beetlebugorg/mini/docs/lineart/img/corner-dark.png

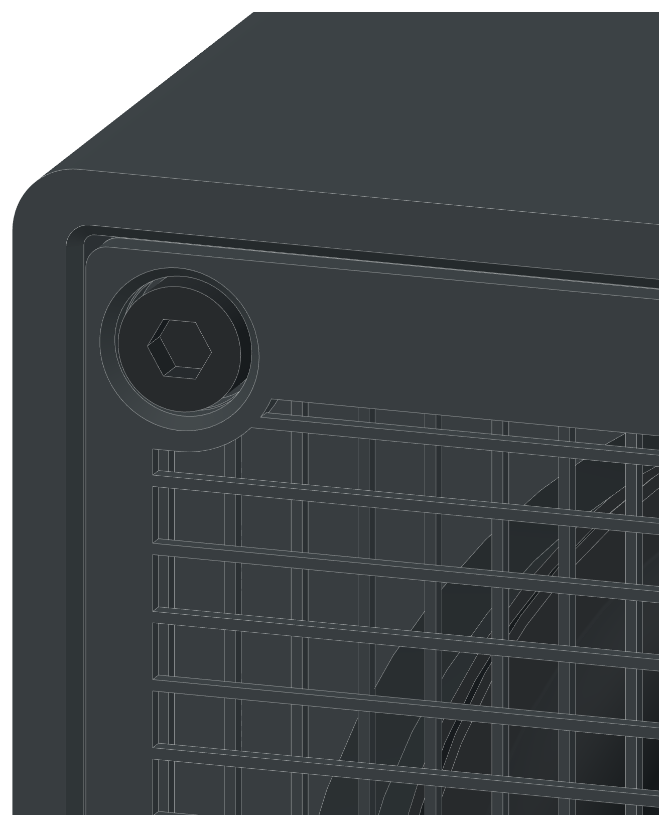
docs/lineart/img/corner-dark.png
