beetlebugorg/mini/docs/lineart/img/corner-light.png

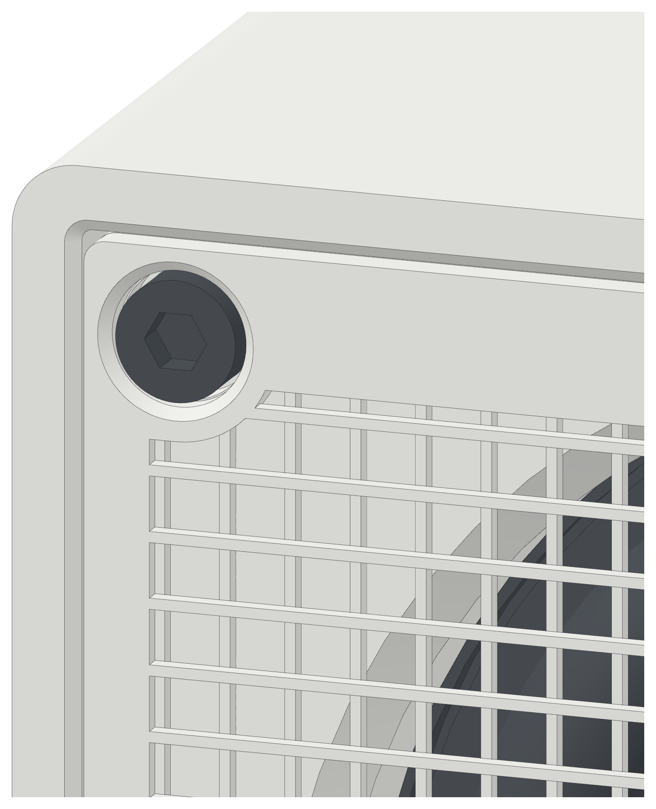
docs/lineart/img/corner-light.png
