beetlebugorg/mini/docs/lineart/img/exploded-dark.png

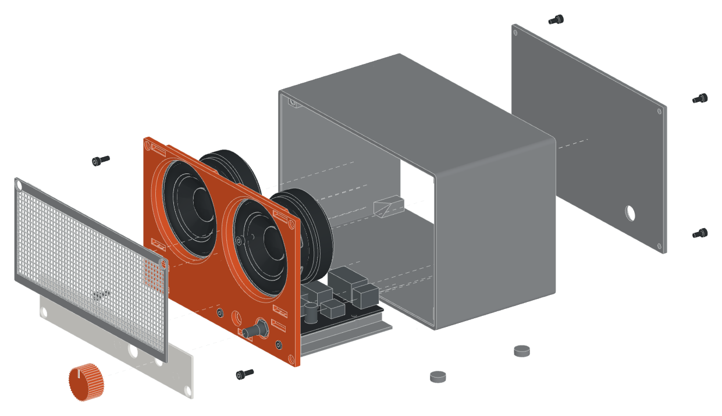
docs/lineart/img/exploded-dark.png
