beetlebugorg/mini/docs/lineart/img/front-light.png

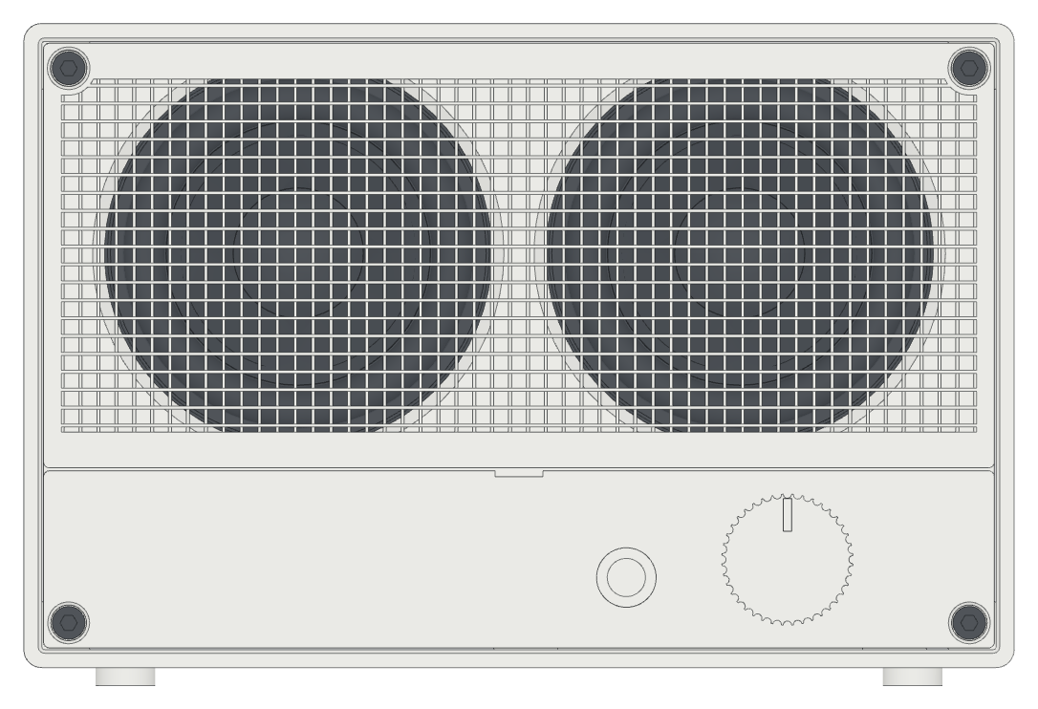
docs/lineart/img/front-light.png
