beetlebugorg/mini/docs/lineart/img/hero-dark.png

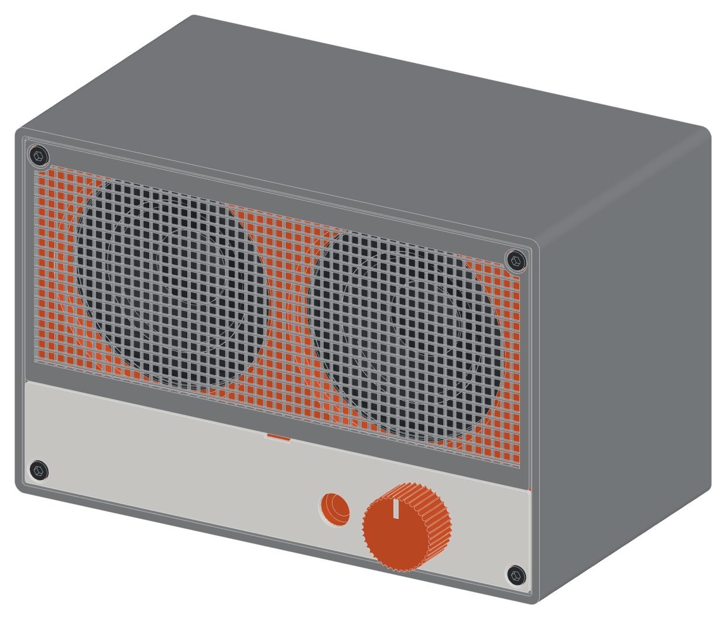
docs/lineart/img/hero-dark.png
