beetlebugorg/mini/docs/lineart/img/pocket-dark.png

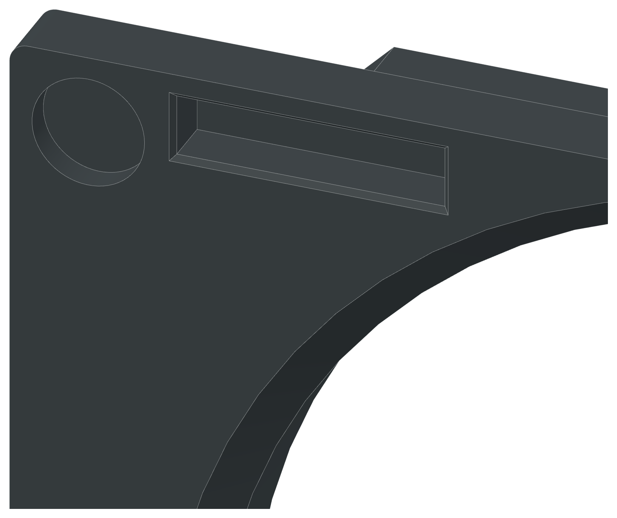
docs/lineart/img/pocket-dark.png
