beetlebugorg/mini/docs/lineart/img/rear-dark.png

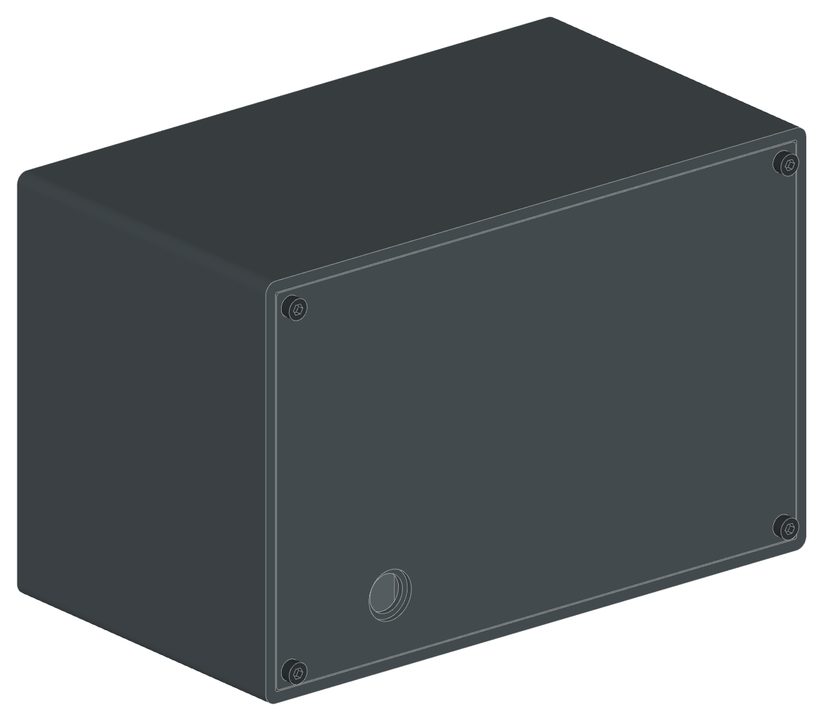
docs/lineart/img/rear-dark.png
