beetlebugorg/mini/docs/lineart/img/snap-light.png

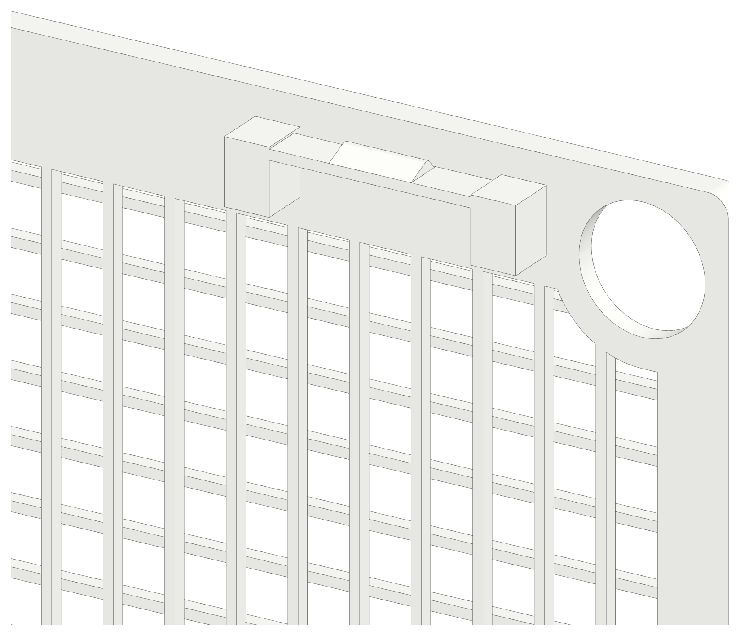
docs/lineart/img/snap-light.png
