beetlebugorg/mini/docs/report-mini/img/baffle_front.png

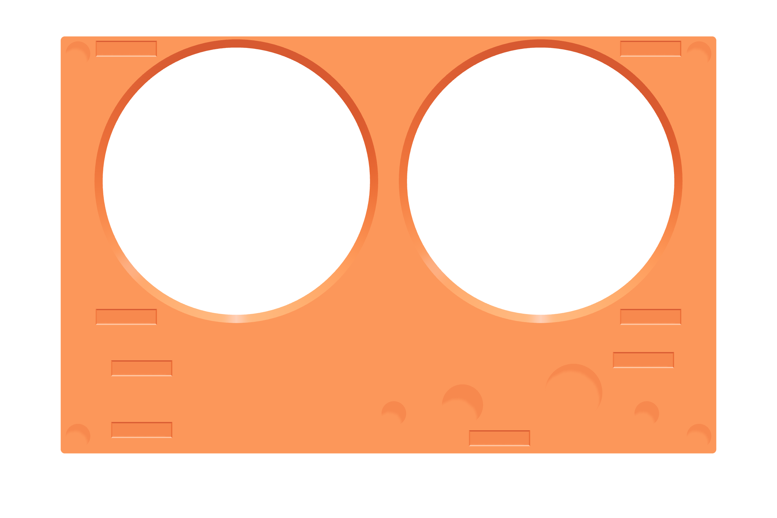
docs/report-mini/img/baffle_front.png
