beetlebugorg/mini/docs/report-mini/img/cut_corner.png

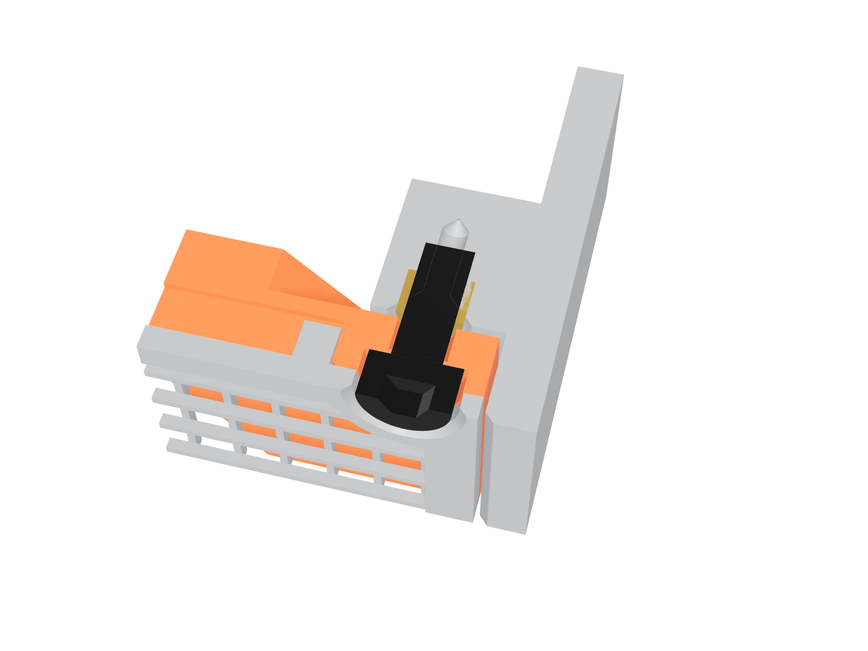
docs/report-mini/img/cut_corner.png
