beetlebugorg/mini/docs/report-mini/img/cut_rear.png

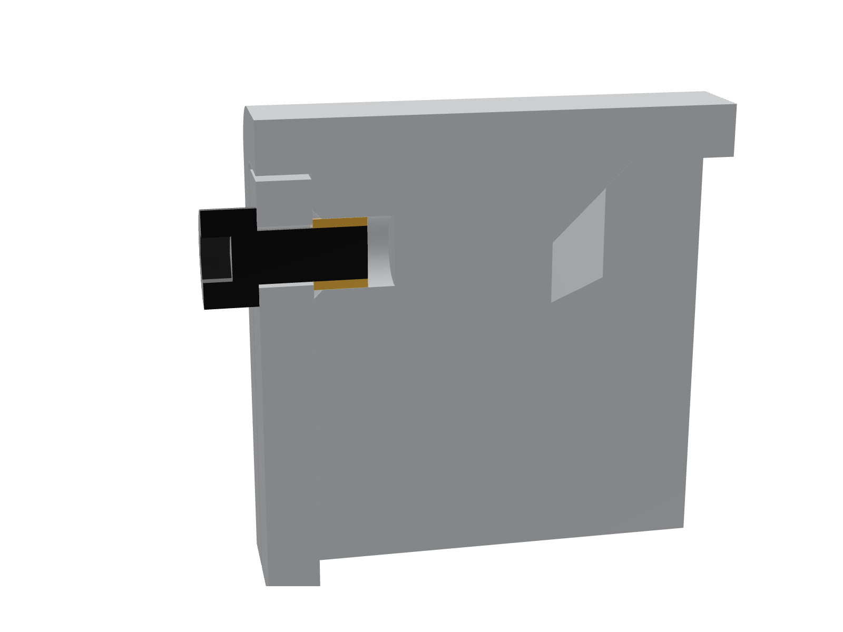
docs/report-mini/img/cut_rear.png
