beetlebugorg/mini/docs/report-mini/img/cut_tray.png

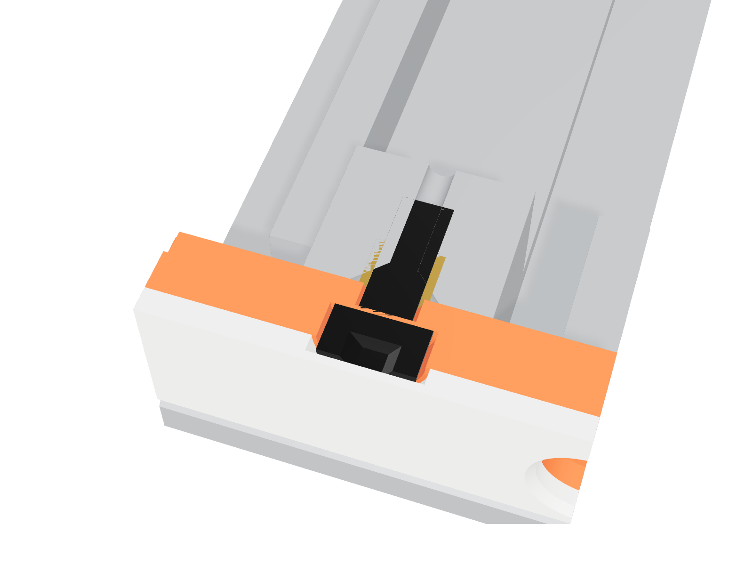
docs/report-mini/img/cut_tray.png
