beetlebugorg/mini/docs/report-mini/img/front.png

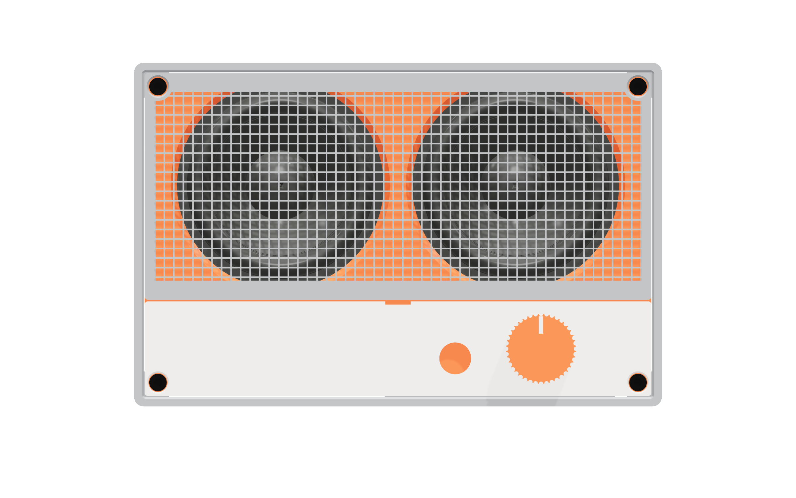
docs/report-mini/img/front.png
