beetlebugorg/mini/docs/report-mini/img/grille_back.png

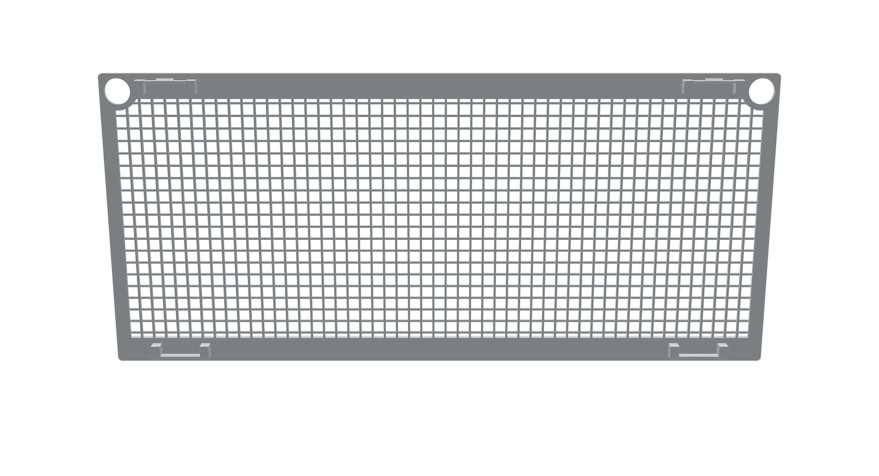
docs/report-mini/img/grille_back.png
