beetlebugorg/mini/docs/report-mini/img/hero.png

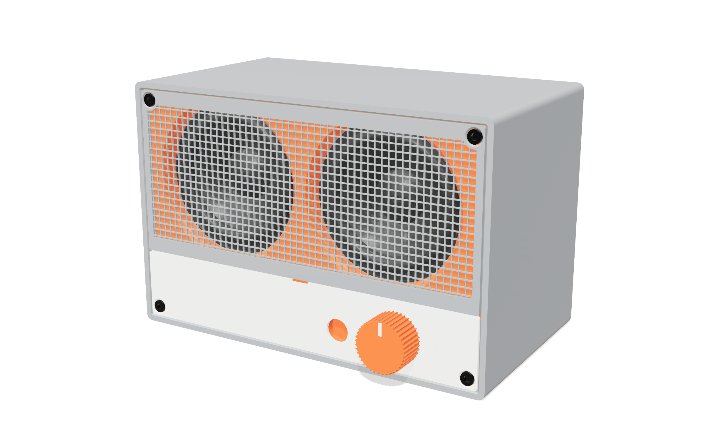
docs/report-mini/img/hero.png
