beetlebugorg/mini/docs/report-mini/img/rear.png

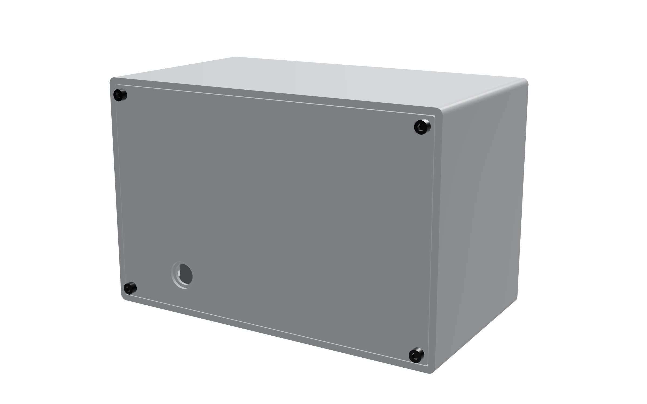
docs/report-mini/img/rear.png
