beetlebugorg/mini/docs/report-mini/img/rear_panel.png

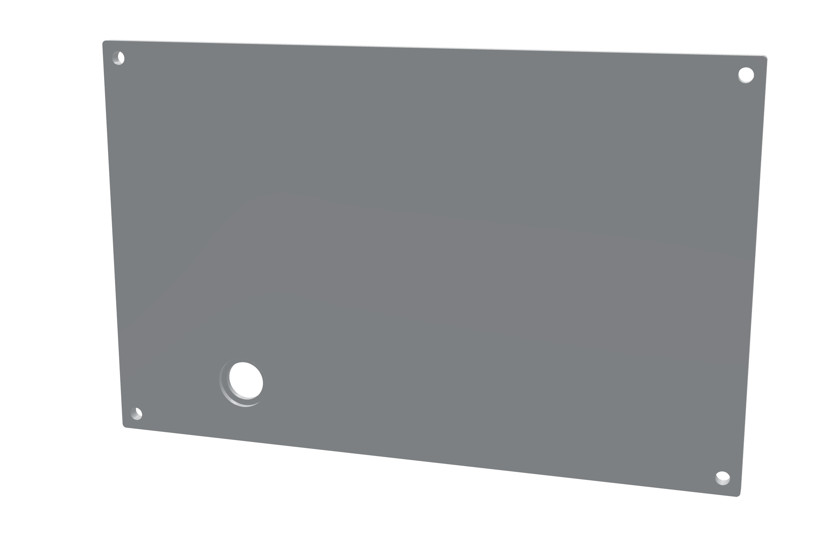
docs/report-mini/img/rear_panel.png
