beetlebugorg/mini/docs/report-mini/img/side.jpg

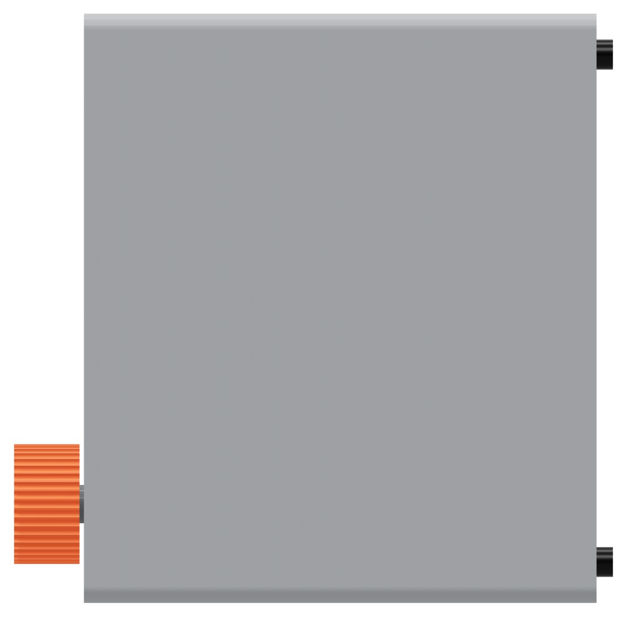
docs/report-mini/img/side.jpg
