beetlebugorg/mini/docs/report-mini/img/top.png

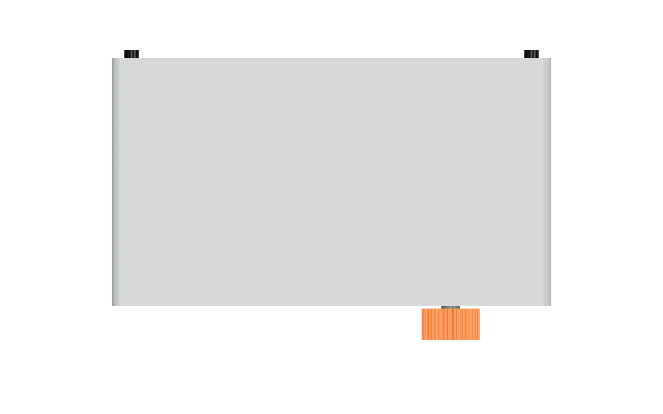
docs/report-mini/img/top.png
