beetlebugorg/mini/docs/report-mini/img/tray.png

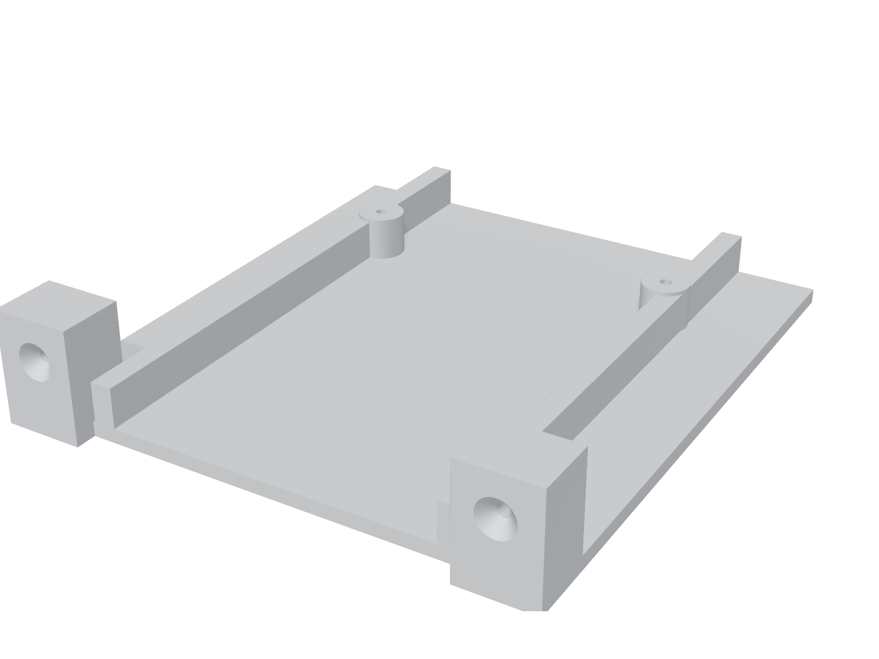
docs/report-mini/img/tray.png
