beetlebugorg/mini/docs/specs-mini/snap.jpg

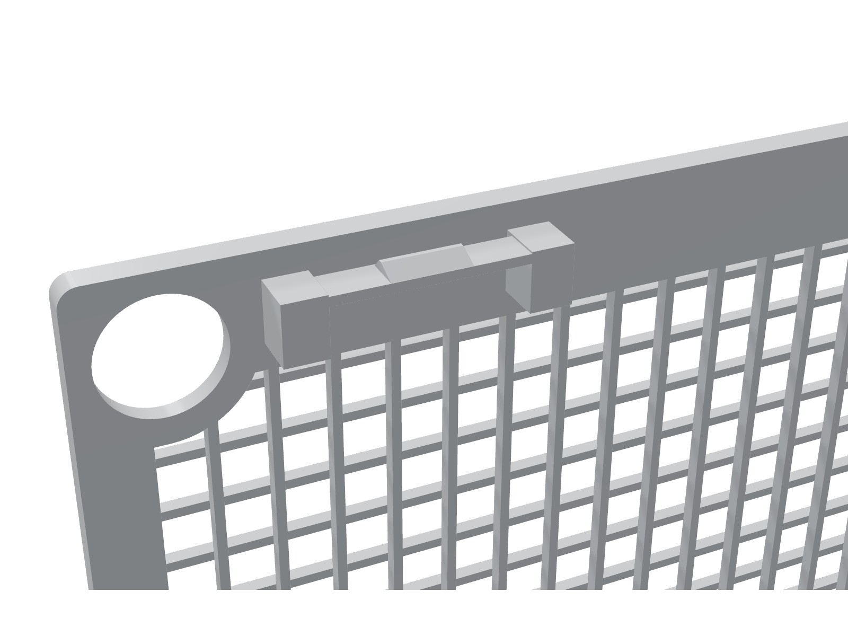
docs/specs-mini/snap.jpg
