beetlebugorg/mini/cad/assembly-mini/amp_board.stl

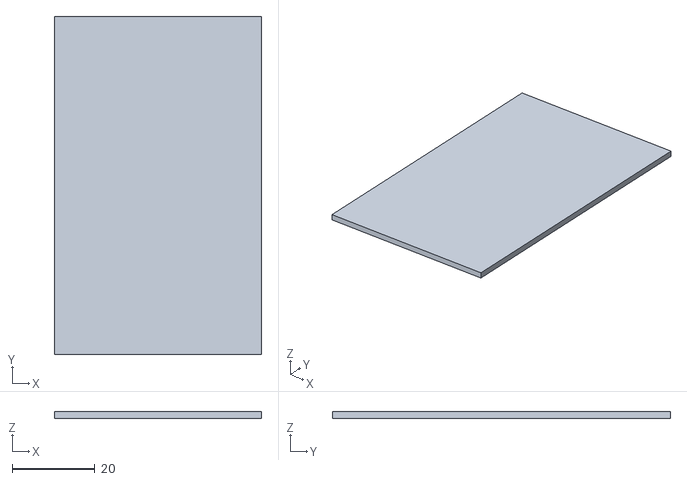
[picture p37: CAD file, 2026-11-04]
cad/assembly-mini/amp_board.stl
50.1 x 81.8 x 1.60
