beetlebugorg/mini/cad/step-mini/sleeve.step

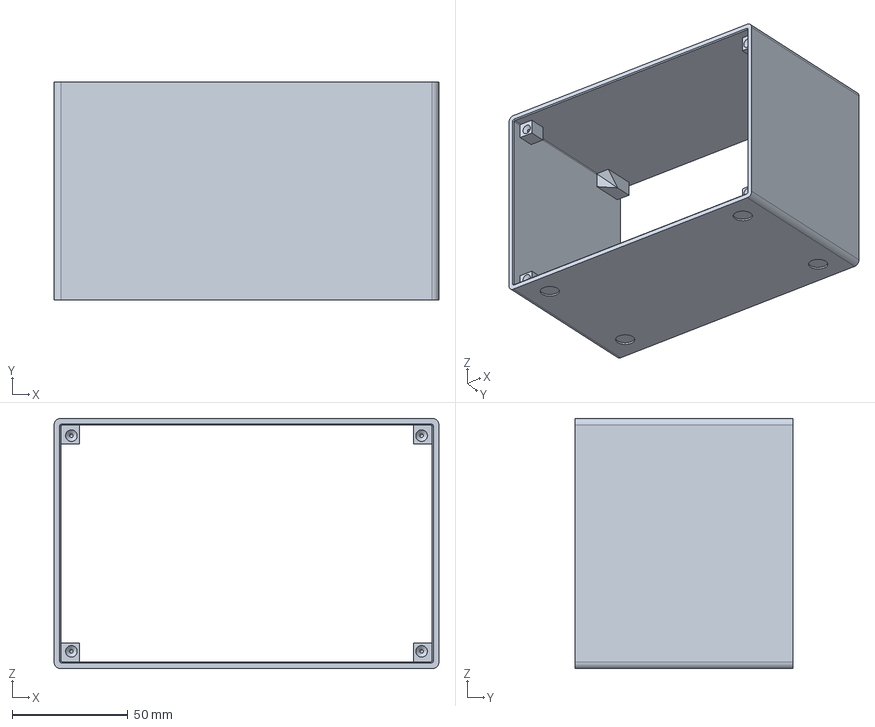
[picture p38: CAD file, 2026-10-19]
cad/step-mini/sleeve.step
166.0 x 94.0 x 108.0 mm
