beetlebugorg/mini/cad/stl-mini/tray.stl

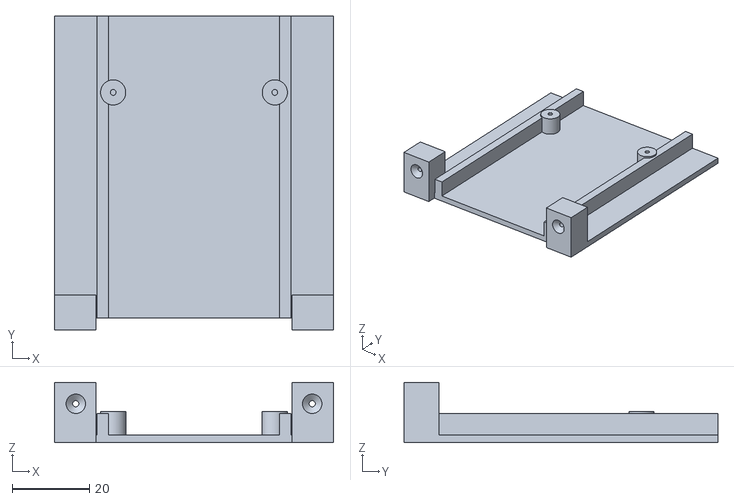
[picture p39: CAD file, 2026-11-04]
cad/stl-mini/tray.stl
72.1 x 81.0 x 15.5
