beetlebugorg/mini/cad/stl-mini/knob.stl

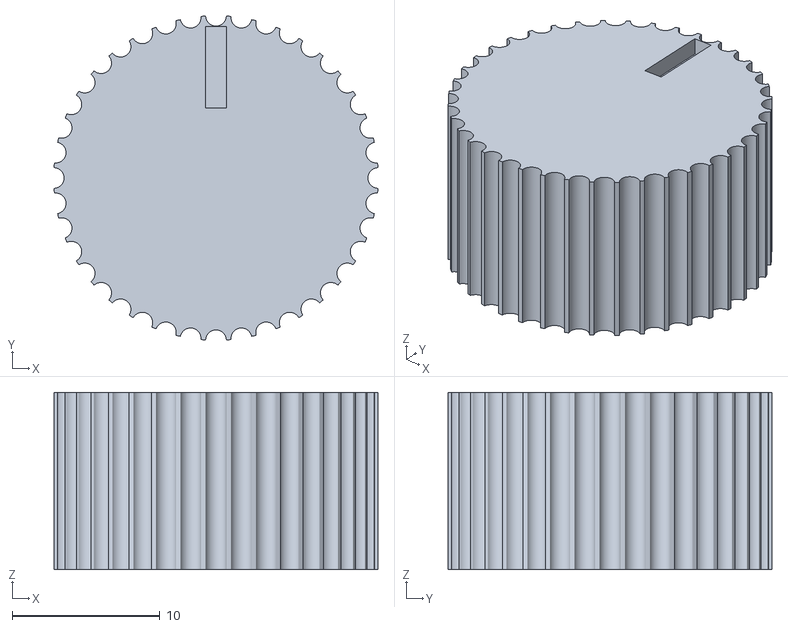
[picture p40: CAD file, 2026-10-19]
cad/stl-mini/knob.stl
22.0 x 22.0 x 12.0
