beetlebugorg/mini/cad/step-mini/rear_panel.step

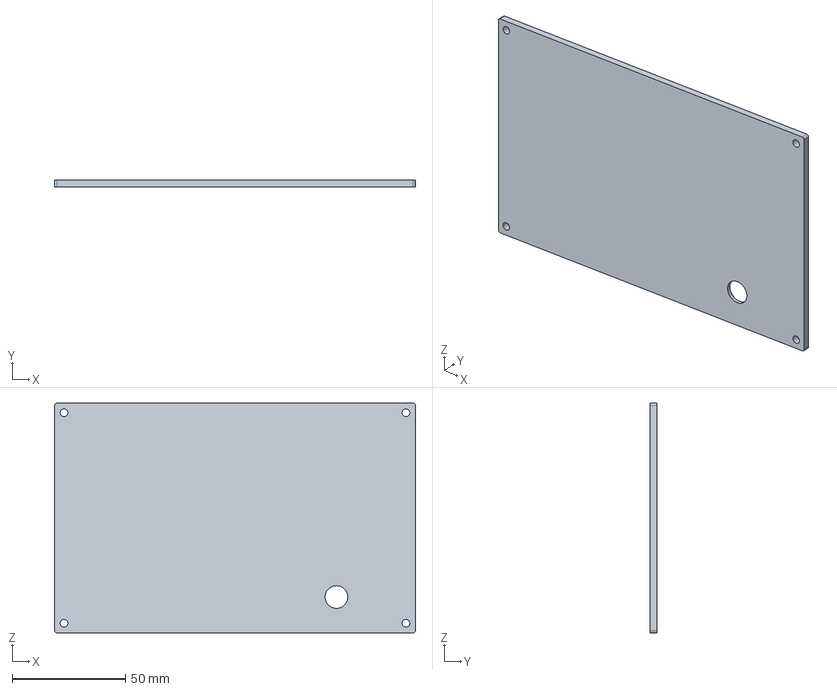
[picture p41: CAD file, 2026-10-19]
cad/step-mini/rear_panel.step
159.4 x 3.00 x 101.4 mm
