beetlebugorg/mini/cad/stl-mini/grille_holes.stl

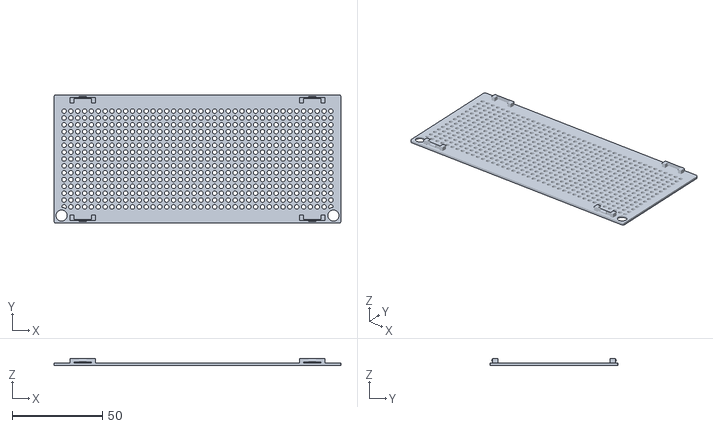
[picture p42: CAD file, 2026-10-19]
cad/stl-mini/grille_holes.stl
159.4 x 71.2 x 4.00
