beetlebugorg/mini/cad/stl-mini/grille_infill_presets.3mf

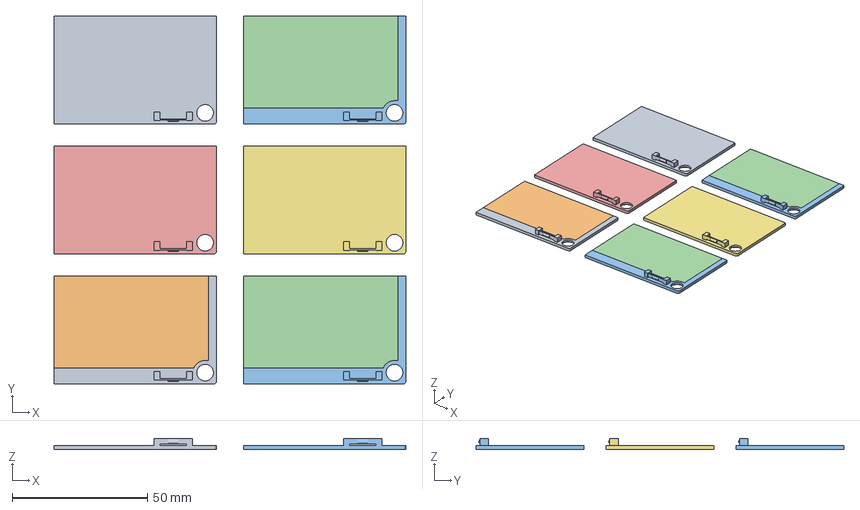
[picture p43: CAD file, 2026-10-19]
cad/stl-mini/grille_infill_presets.3mf
130.0 x 136.0 x 4.00 mm
coupon 1 plate
coupon 1 window (Lattice 3.0)
coupon 2 plate
coupon 2 window (Lattice 2.0)
coupon 3 plate
coupon 3 window (Diamond 3.0)
coupon 4 plate
coupon 4 window (Grid 3.0)
coupon 5 plate
coupon 5 window (Triangles 4.0)
coupon 6 plate
coupon 6 window (Trihexagon 4.0)
