beetlebugorg/mini/cad/assembly-mini/speaker_r.stl

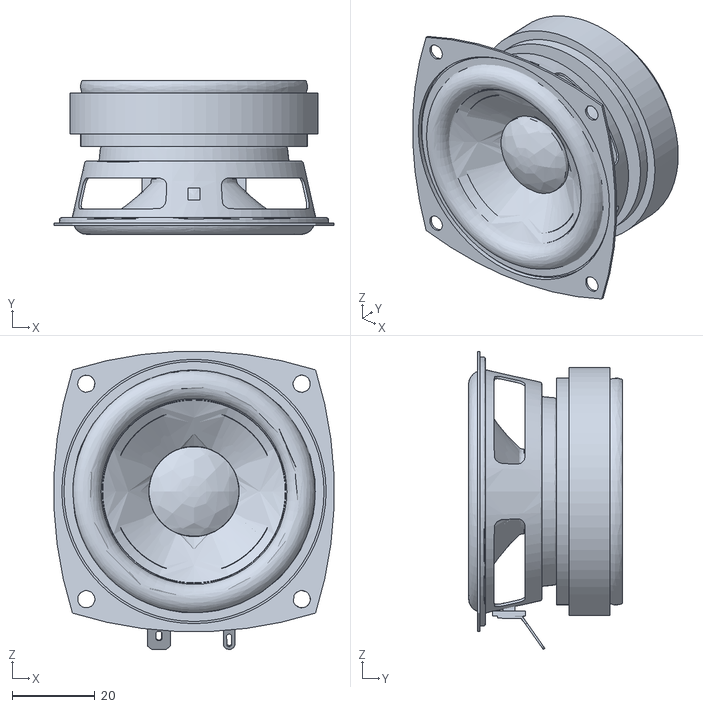
[picture p44: CAD file, 2026-11-03]
cad/assembly-mini/speaker_r.stl
67.8 x 37.3 x 72.2
