beetlebugorg/mini/cad/step-mini/knob_mark.step

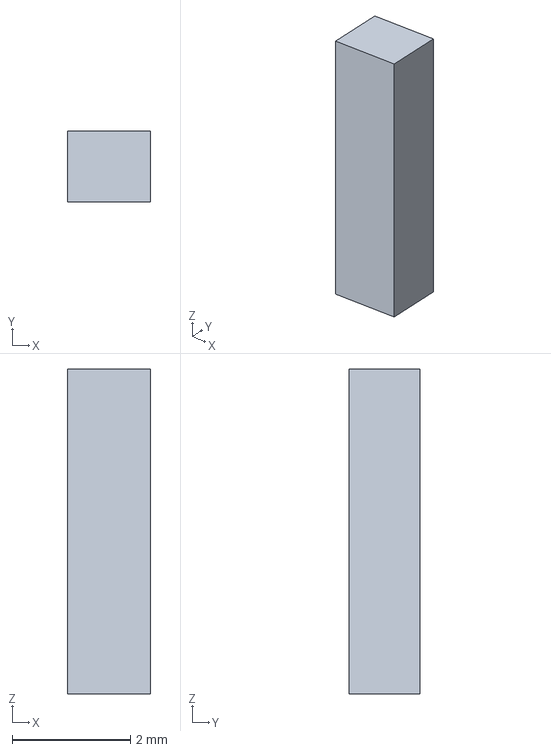
[picture p45: CAD file, 2026-10-19]
cad/step-mini/knob_mark.step
1.40 x 1.20 x 5.50 mm
