beetlebugorg/mini/cad/step-mini/baffle.step

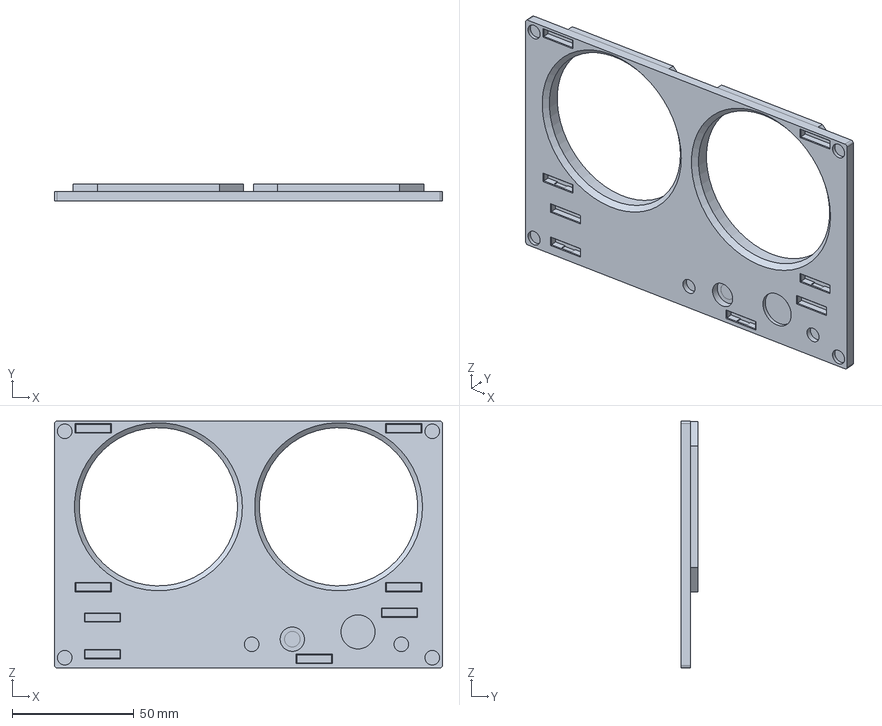
[picture p46: CAD file, 2026-10-19]
cad/step-mini/baffle.step
159.4 x 7.00 x 101.4 mm
