beetlebugorg/mini/cad/assembly-mini/inserts_tray.stl

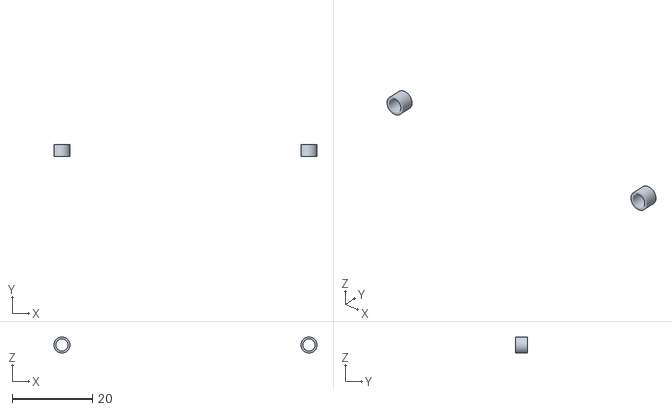
[picture p47: CAD file, 2026-11-03]
cad/assembly-mini/inserts_tray.stl
65.5 x 3.00 x 3.98
