beetlebugorg/mini/cad/step-mini/feet.step

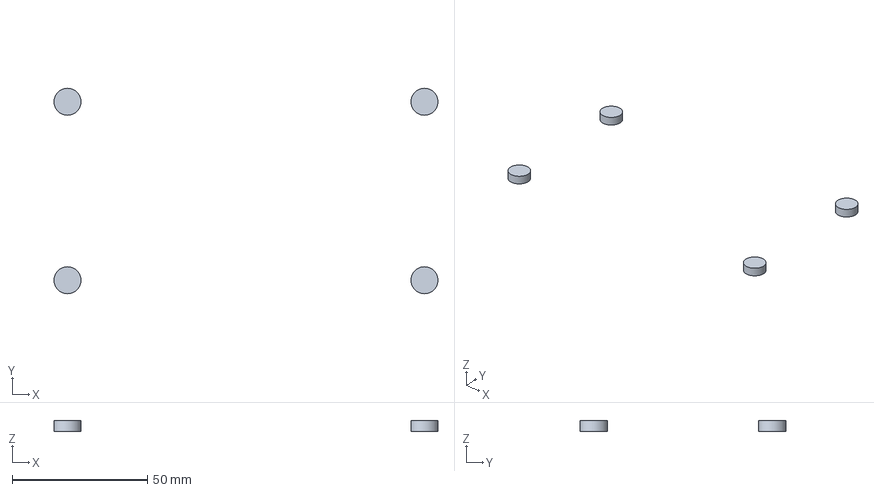
[picture p48: CAD file, 2026-10-19]
cad/step-mini/feet.step
142.0 x 76.0 x 3.90 mm
