beetlebugorg/mini/cad/assembly-mini/grille.stl

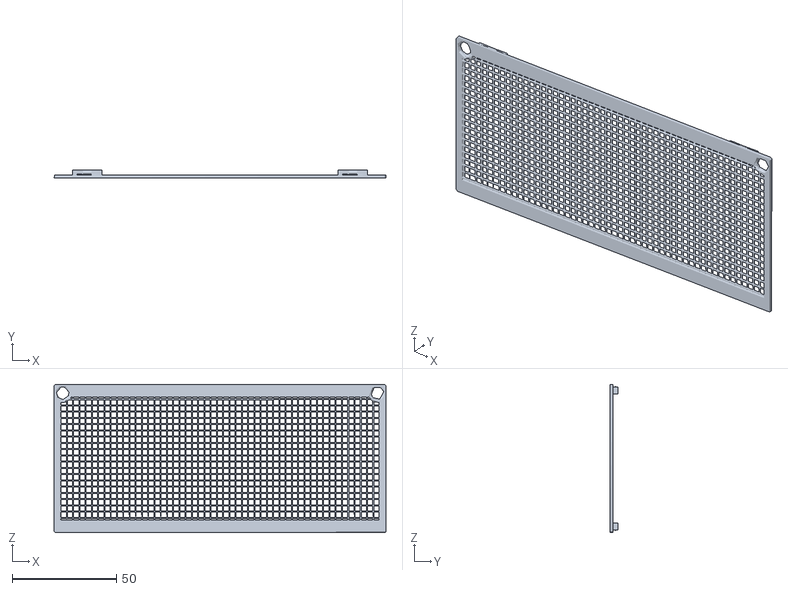
[picture p49: CAD file, 2026-11-03]
cad/assembly-mini/grille.stl
159.3 x 4.00 x 71.2
