beetlebugorg/mini/cad/assembly-mini/control_strip.stl

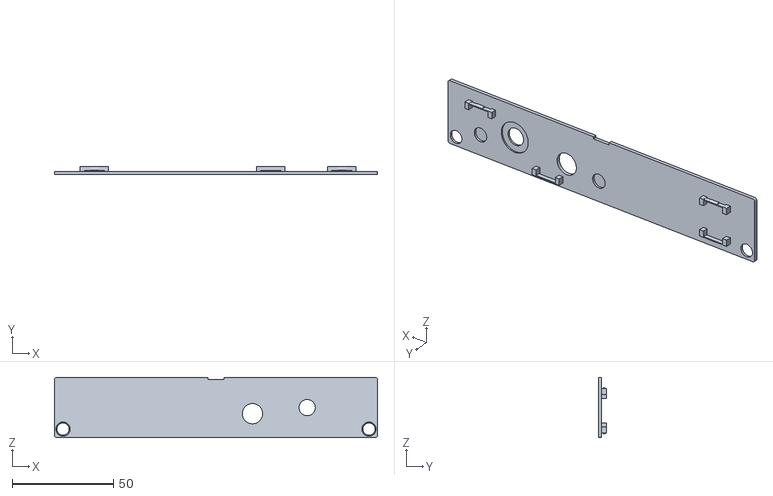
[picture p50: CAD file, 2026-11-03]
cad/assembly-mini/control_strip.stl
159.4 x 4.00 x 29.7
