beetlebugorg/mini/(list of files, cad)

Other CAD files:
cad/assembly-mini/tray.stl
cad/step-mini/grille.step
cad/assembly-mini/sleeve.stl
cad/assembly-mini/knob_mark.stl
cad/assembly-mini/pot_nut.stl
cad/assembly-mini/screws_board.stl
cad/assembly-mini/screws_front.stl
cad/assembly-mini/screws_rear.stl
cad/assembly-mini/screws_tray.stl
cad/step-mini/screws_board.step
cad/step-mini/screws_front.step
cad/stl-mini/feet.stl
cad/stl-mini/grille.stl
