beetlebugorg/mini/docs/lineart/img/step1-light.png

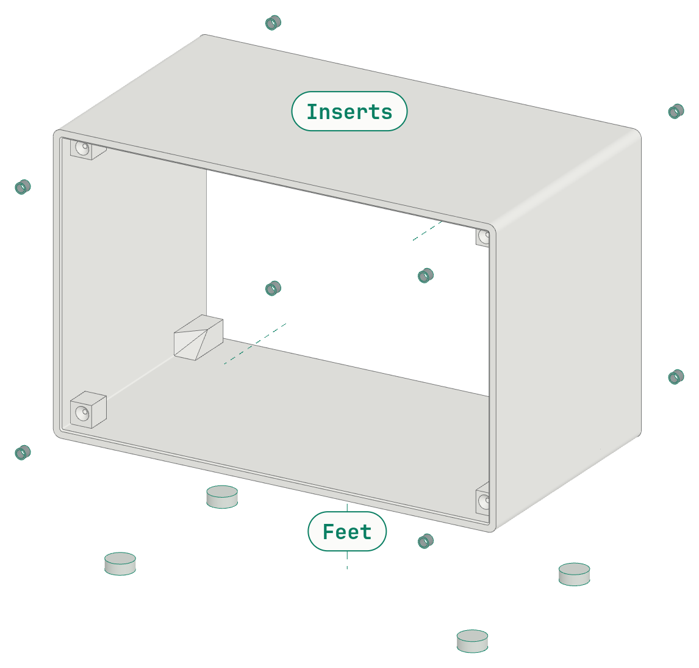
docs/lineart/img/step1-light.png
