beetlebugorg/mini/docs/lineart/img/step2-light.png

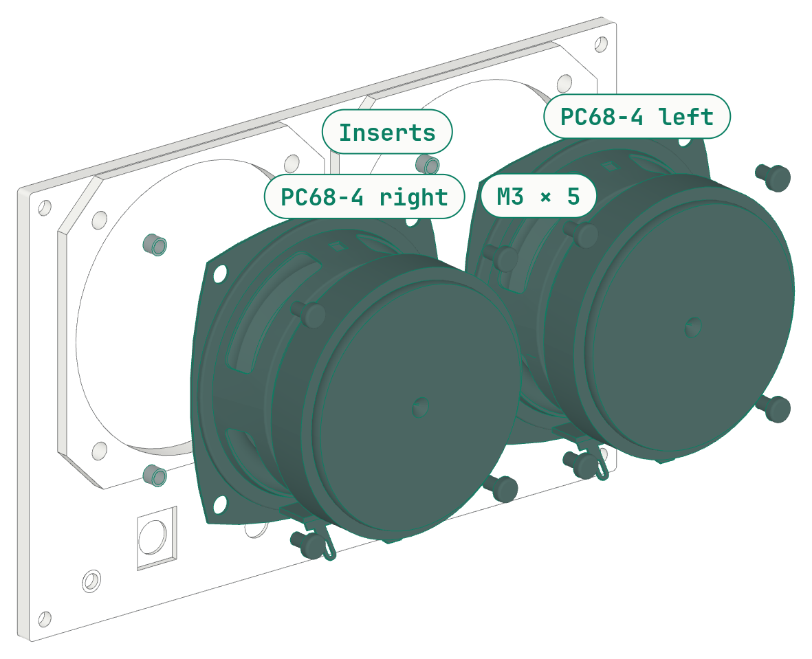
docs/lineart/img/step2-light.png
