beetlebugorg/mini/docs/lineart/img/step4-dark.png

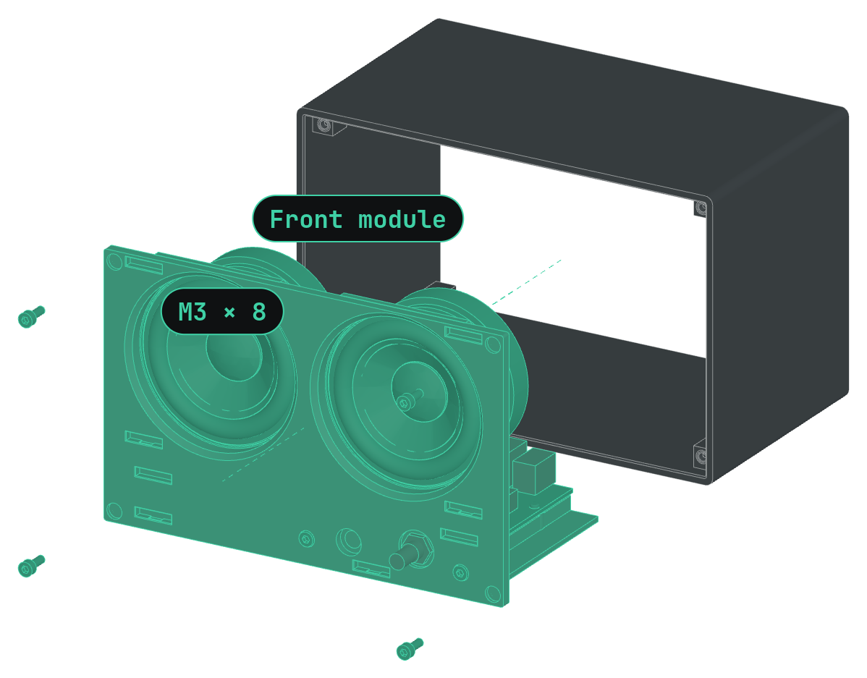
docs/lineart/img/step4-dark.png
