beetlebugorg/mini/docs/lineart/img/step4-light.png

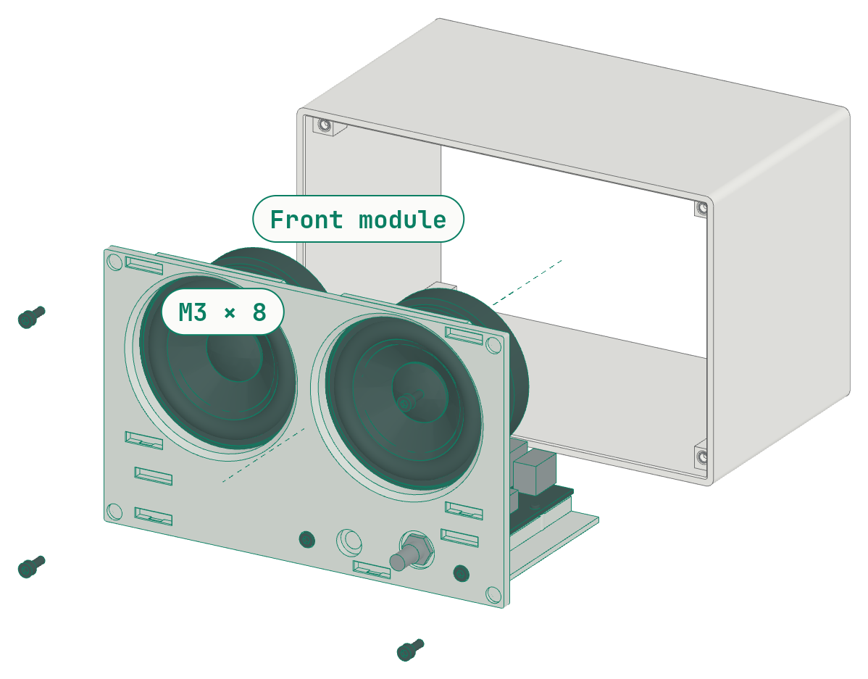
docs/lineart/img/step4-light.png
