beetlebugorg/mini/docs/lineart/img/step5-dark.png

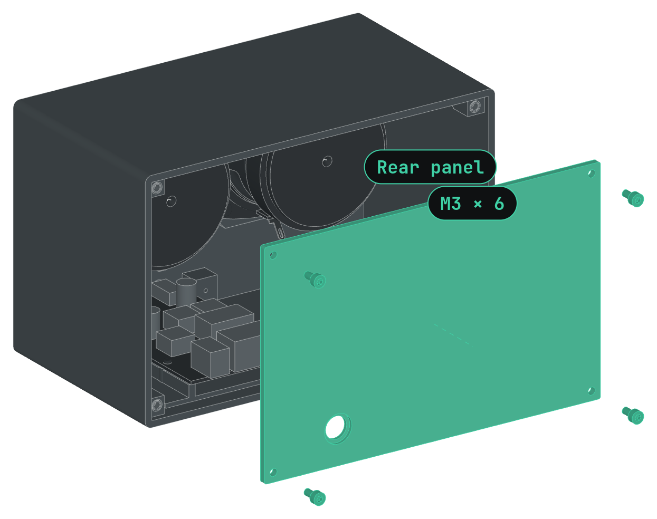
docs/lineart/img/step5-dark.png
