beetlebugorg/mini/docs/report-mini/img/print_baffle.png

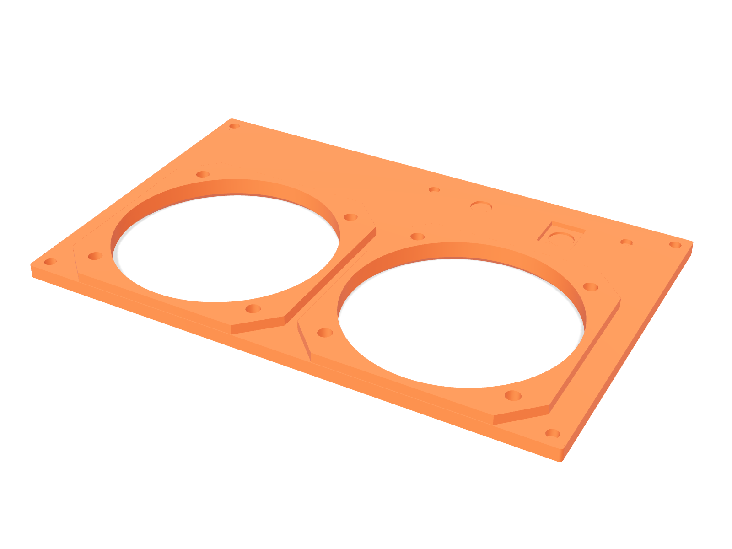
docs/report-mini/img/print_baffle.png
