beetlebugorg/mini/docs/report-mini/img/print_control_strip.png

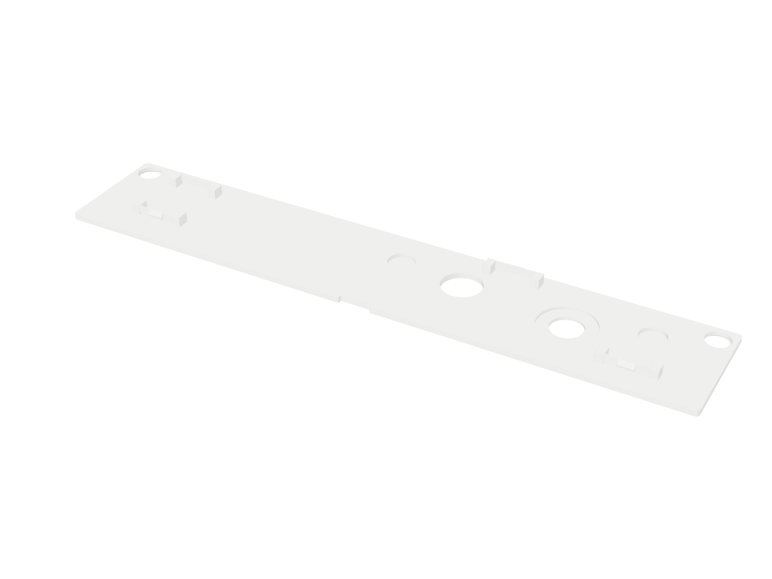
docs/report-mini/img/print_control_strip.png
