beetlebugorg/mini/docs/report-mini/img/print_grille.png

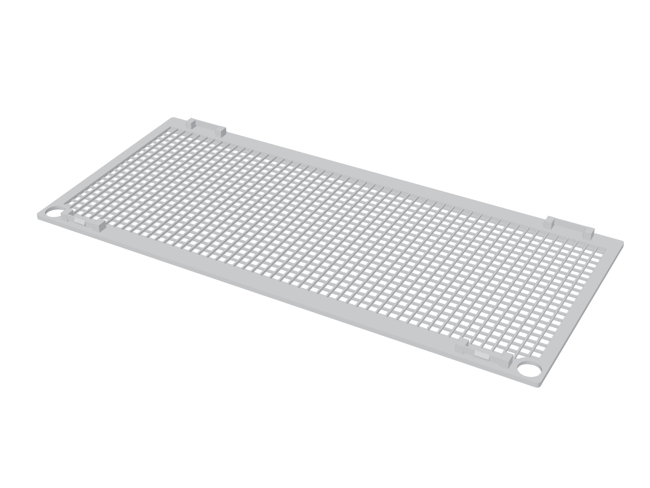
docs/report-mini/img/print_grille.png
