beetlebugorg/mini/docs/report-mini/img/print_sleeve.png

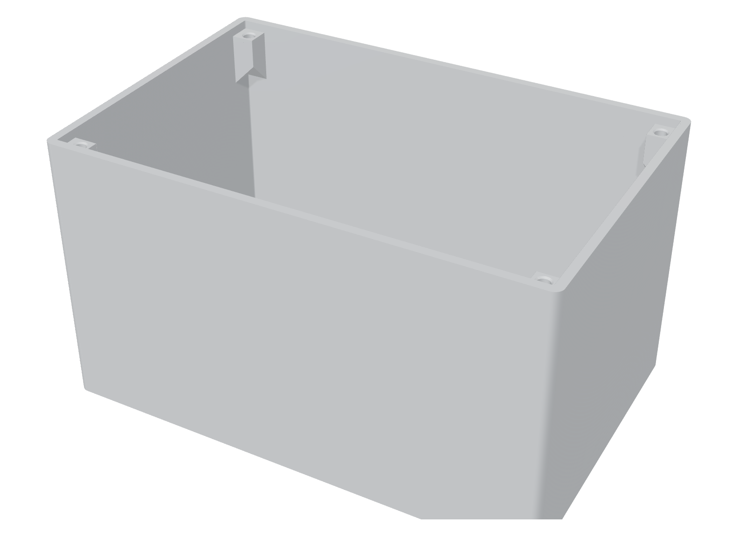
docs/report-mini/img/print_sleeve.png
