beetlebugorg/mini/docs/report-mini/img/print_tray.png

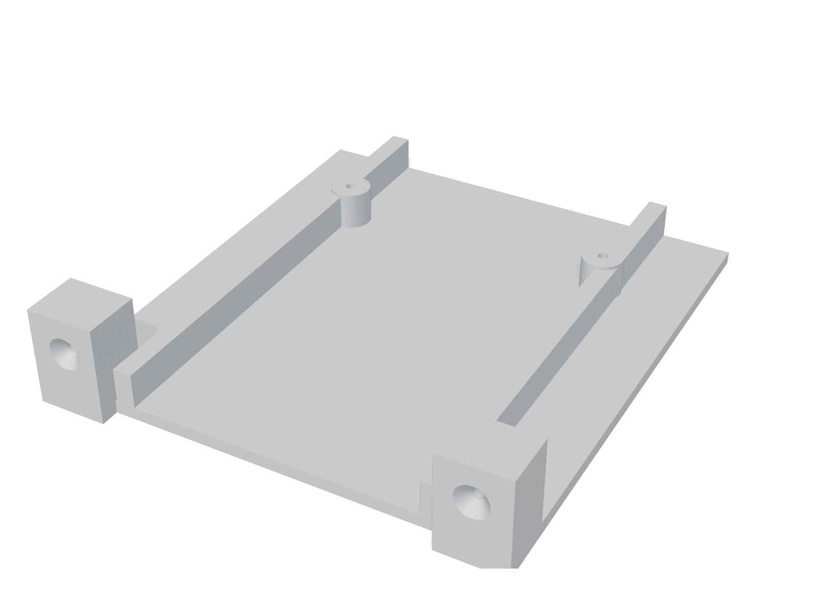
docs/report-mini/img/print_tray.png
