beetlebugorg/mini/(commit log)

2026-10-19 Add the Bluespeaker Mini
    A Bluetooth desk speaker with two PC68-4 drivers and a ZK-502C amplifier.
    The repo has the build123d model, the Cura and Orca profiles, the
    drawings, the spec sheet, the engineering report, and the docs page.
    docs/lineart renders the line-art images in the beetlebug.org style. The
    Pages workflow publishes docs/.
2026-11-03 Render the hero and the exploded view in the filament colors
    The printed parts of these two shots now show their filament: grey,
    orange and white. The drawings stay line art.
2026-11-03 Add printdeck.yml for the Printdeck builds of the Mini
    The plan has the nine printed parts with the Cura profiles of cura/ on
    the TAZ Workhorse SE, three PLA colours, the spec sheet, the report,
    and the Mini in its parts for the Parts tab. cad/mini_assembly.py
    writes the parts in their places from the glTF files of the design
    page.
2026-11-03 Update Pillow, certifi and puppeteer-core for security fixes
    Pillow 13.0.0 and certifi 2026.10.23 fix the open Dependabot alerts
    of uv.lock. threejs-materials 1.2.4 held Pillow below 12.3, and 1.2.5
    allows Pillow 13.
    puppeteer-core 25.16.0 drops extract-zip and basic-ftp from the tree
    of docs/lineart, and gets zod 4.6.7. npm audit reports 0
    vulnerabilities. render.mjs makes the same hero image as before.
2026-11-03 Check the part STL files in the generate step of printdeck.yml
    The plan run on GitHub runs cad/bluespeaker_mini.py --stl and fails
    when the nine part STL files differ from the committed files. A local
    run with the locked packages makes the same files.
2026-11-04 Print the Printdeck grille in white with a honeycomb window
    The export writes cad/stl-mini/grille_honeycomb.3mf: the grille plate
    and a window of honeycomb infill at 20 %, with no walls and no top or
    bottom layers. The Grille part of printdeck.yml uses it, in white.
    Printdeck gives the 3MF values to CuraEngine as they are. CuraEngine
    stops on the "=0" values of the other 3MF files, and calculates no
    line distance. It also puts each build item at a different place on
    the bed. This file has plain values, the line distance, and one group.
2026-11-04 Place the grille G-code model in the assembly with a transform
    The new plan run of printdeck-action makes a 3D model of the grille
    from its G-code, in the coordinates of grille_honeycomb.3mf. The
    transform of the Grille item puts it in its place in the assembly.
    The 3MF bounds with the transform match the bounds of grille_plate().
2026-11-04 Test the plan run of printdeck-action plan-slice (remove before merge)
    The plan job uses beetlebugorg/printdeck-action@plan-slice, the branch
    of beetlebugorg/printdeck-action#1. Remove this commit before the merge.
2026-11-04 Print the parts on the shared 0.20 Standard profile with brims
    The profile folder has the 0.10 Fine, 0.20 Standard and 0.30 Fast
    profiles of the other Printdeck projects in place of the three 0.25
    Mini profiles. The calibration of the filament (220 C, xy_offset,
    hole_xy_offset, shrinkage) goes into the three materials.
    Each part prints on 0.20 Standard, and its settings in printdeck.yml
    keep the old tuning: 6 walls and supports for the sleeve, 4 walls and
    40 % infill for the parts, one line per rib with no expansion for the
    grille. The flat parts have a brim. The sleeve and the grille print
    alone, because some of their settings are for the whole plate.
2026-11-04 Give the snap catch posts 0.25 mm clearance in the baffle pockets
    With 0.15 mm the posts of the printed grille, strip and fit test bound
    in the pockets, and the click was too hard. The click interference is
    snap_bump - snap_clear, so the wider pocket also lowers it: 0.15 mm on
    the strip and 0.245 mm on the grille, from 0.25 and 0.345. Only the
    baffle pockets change. The report text takes the values from the
    parameters.
2026-11-04 Put the amp tray posts under the measured ZK-502C rear holes
    The rear hole X values were estimates (3.0 and 47.5 mm). On a printed
    tray the posts missed the holes, and the left screw pulled the board
    off centre. The holes are now 4.15 mm from the side edges and 60.81 mm
    from the front edge, measured with calipers on the hole centres.
    The board is 50.05 x 81.77 mm (it was 50.5 x 82.0). The right tray tab
    moves 0.45 mm in, so the baffle screw hole and the control strip
    pocket for its screw head move with it.
